CynthiaVN2016/CPSC-334-Final/images/IMG_0665.jpg

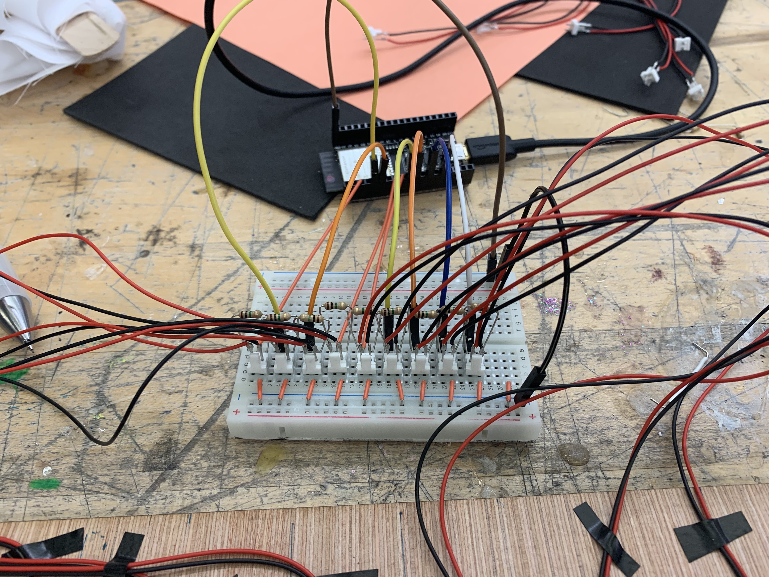
images/IMG_0665.jpg
